moogway82/JamSoftElectronULA/Hardware/BOTTOM Board/BOM_JamSoftElectronULA_BOT.csv

ID | Name | Designator | Footprint | Quantity | Manufacturer Part | Manufacturer | Supplier | Supplier Part | Price
1 | 4K7 | R16,R17,R18,R19 | R0402 | 4 |  |  | JLCPCB | C25900 | 0.001
2 | ElectronULA_2 | U13 | PGA-68_L29.5-W29.5-P2.54-BL_ELECTRON_ULA | 1 |  |  | LCSC | C5156444 | 0.511
3 | 10K | R2 | R0402 | 1 |  |  | JLCPCB | C25744 | 0.001
4 | 22u | DCD-5V | C0603 | 1 |  |  | JLCPCB | C59461 | 0.008
