moogway82/JamSoftElectronULA/Hardware/TOP Board/BOM_JamSoftElectronULA_TOP.csv

ID | Name | Designator | Footprint | Quantity | Manufacturer Part | Manufacturer | Supplier | Supplier Part | Price
1 | 51Ω | RN7,RN8,RN1,RN2,RN3,RN5,RN9,RN10 | RES-ARRAY-SMD_0804-8P-L2.0-W1.0-BL | 8 | CAT10-510J4LF | BOURNS | LCSC | C148527 | 0.035
2 | 50 | R20,R52 | R0402 | 2 |  |  | JLCPCB | C25120 | 0.001
3 | BAT54 | D2 | D_SOD-323_HANDSOLDERING | 1 | NSVBAT54HT1G | onsemi | LCSC | C179609 | 0.102
4 | 1N5819/SOD-123 | U12 | SOD-123_L2.7-W1.7-LS3.8-RD | 1 | 1N4148W | ST(Semtech) | JLCPCB | C81598 | 0.01
5 | ICE40HX1K-VQ100 | U4 | LATC-VQFP-100 | 1 | ICE40HX1K-VQ100 | Lattice | LCSC | C1519043 | 14.318
6 | SN74HCT125D | U10 | TSSOP14 | 1 | 74HCT125PW,118 | Nexperia | LCSC | C131316 | 0.171
7 | 33 | R21 | R0402 | 1 |  |  | JLCPCB | C25105 | 0.001
8 | ULA-ADP-A1 | J2 | HDR-M-2.54_2X10 | 1 |  |  | LCSC | C7494883 | 0.246
9 | ULA-ADP-A2 | J10 | HDR-M-2.54_2X10 | 1 |  |  | LCSC | C7494883 | 0.246
10 | ULA-ADP-A3 | J11 | HDR-M-2.54_2X10 | 1 |  |  | LCSC | C7494883 | 0.246
11 | ULA-ADP-A4 | J12 | HDR-M-2.54_2X10 | 1 |  |  | LCSC | C7494883 | 0.246
12 | TLV1117LV12DCYR | U2 | SOT-223_L6.5-W3.5-P2.30-LS7.0-BR | 1 | TLV1117LV12DCYR | Texas Instruments | LCSC | C80106 | 0.222
13 | 10K | R8,R9,R10,R11,R14,R15,R5,R7,R66,R65,R31,R4,R12,R13,R1,R6 | R0402 | 16 |  |  | JLCPCB | C25744 | 0.001
14 | 22k | R3 | R0402 | 1 |  |  | JLCPCB | C25768 | 0.001
15 | 2.2k | R22 | R0402 | 1 |  |  | JLCPCB | C25879 | 0.001
16 | 470k | R30 | R0402 | 1 |  |  | JLCPCB | C25790 | 0.001
17 | W25X05CLSNIG | U8 | SOIC-8_L4.9-W3.9-P1.27-LS6.0-BL | 1 | W25X05CLSNIG TR | Winbond | LCSC | C401657 | 0.366
18 | PROG | J1 | HDR-M-2.54_2X4 | 1 |  |  | LCSC | C18198018 | 0.137
19 | 10kΩ | RN4,RN6 | RES-ARRAY-SMD_0804-8P-L2.0-W1.0-BL | 2 | CAY10-103J4LF | BOURNS | LCSC | C1731037 | 0.102
20 | LM39100S-3.3 | U1 | SOT-223_L6.5-W3.5-P2.30-LS7.0-BR | 1 | LM39100S-3.3 | HTC Korea TAEJIN Tech | LCSC | C126055 | 0.284
21 | MCP6566R | U5 | SOT-23-5_L3.0-W1.7-P0.95-LS2.8-BR | 1 | MCP6566RT-E/OT | Microchip Tech | LCSC | C623507 | 1.386
22 | 74ALVC164245DGG | U6,U7,U9,U11 | TSSOP-48_L12.6-W6.2-P0.50-LS8.1-BL | 4 | 74ALVC164245DGG:11 | Nexperia | LCSC | C5531 | 0.881
23 | 22u | DCC-5V,DCB-5V,DCB-3V3,DCC-1V2 | C0603 | 4 |  |  | JLCPCB | C59461 | 0.008
24 | 10u | DC6A3,DC6B3,DC7A3,DC7B3,DC9A3,DC9B3,DC11A3,DC11B3,DCA-1V2,DCA-3V3 | C0402 | 10 |  |  | JLCPCB | C15525 | 0.005
25 | 0.1u | DC3,DC6A1,DC6B1,DC7A1,DC7B1,DC9A1,DC9B1,DC11A1,DC5,DC8,DC10,DC4-11,DC4-14,DC4-6,DC4-92,DC4-88,DC4-77,DC4-67,DC4-61,DC4-58,DC4-38,DC4-22,DC4-31,DC4-35,DC11B2,DC11B1,DC6B2,DC6A2,DC11A2,DC9A2,DC7B2,DC7A2,DC9B2 | C0402 | 33 |  |  | JLCPCB | C1525 | 0.001
26 | APX803S00-29SA-7 | U3 | SOT-23-3_L2.9-W1.3-P1.90-LS2.4-BR | 1 | APX803S00-29SA-7 | Diodes Incorporated | LCSC | C526392 | 0.162
