moogway82/JamSoftElectronULA/Schematic_JamSoftElectronULA.pdf

+5V
+3.3V

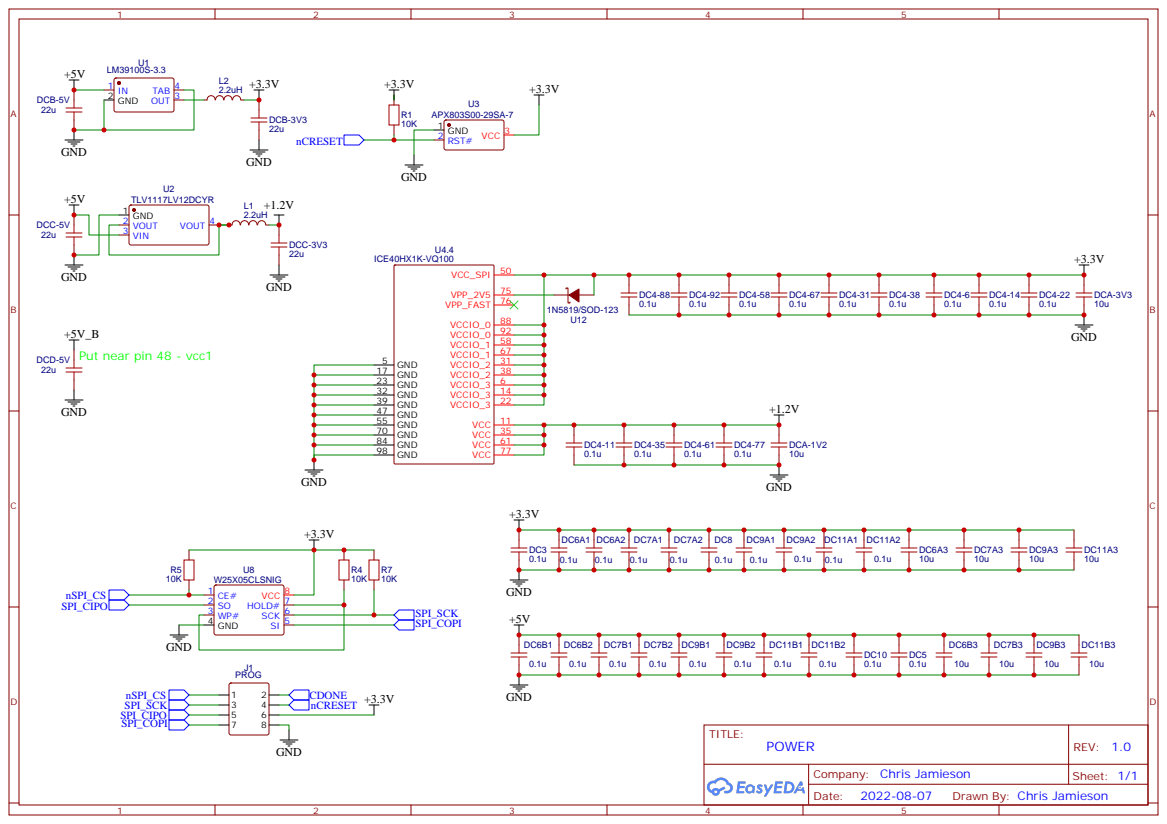
[picture p9: page 1]

Drawn By: Chris Jamieson

# 1B3 6 VCCB

# 2B3 17 VCCB 18

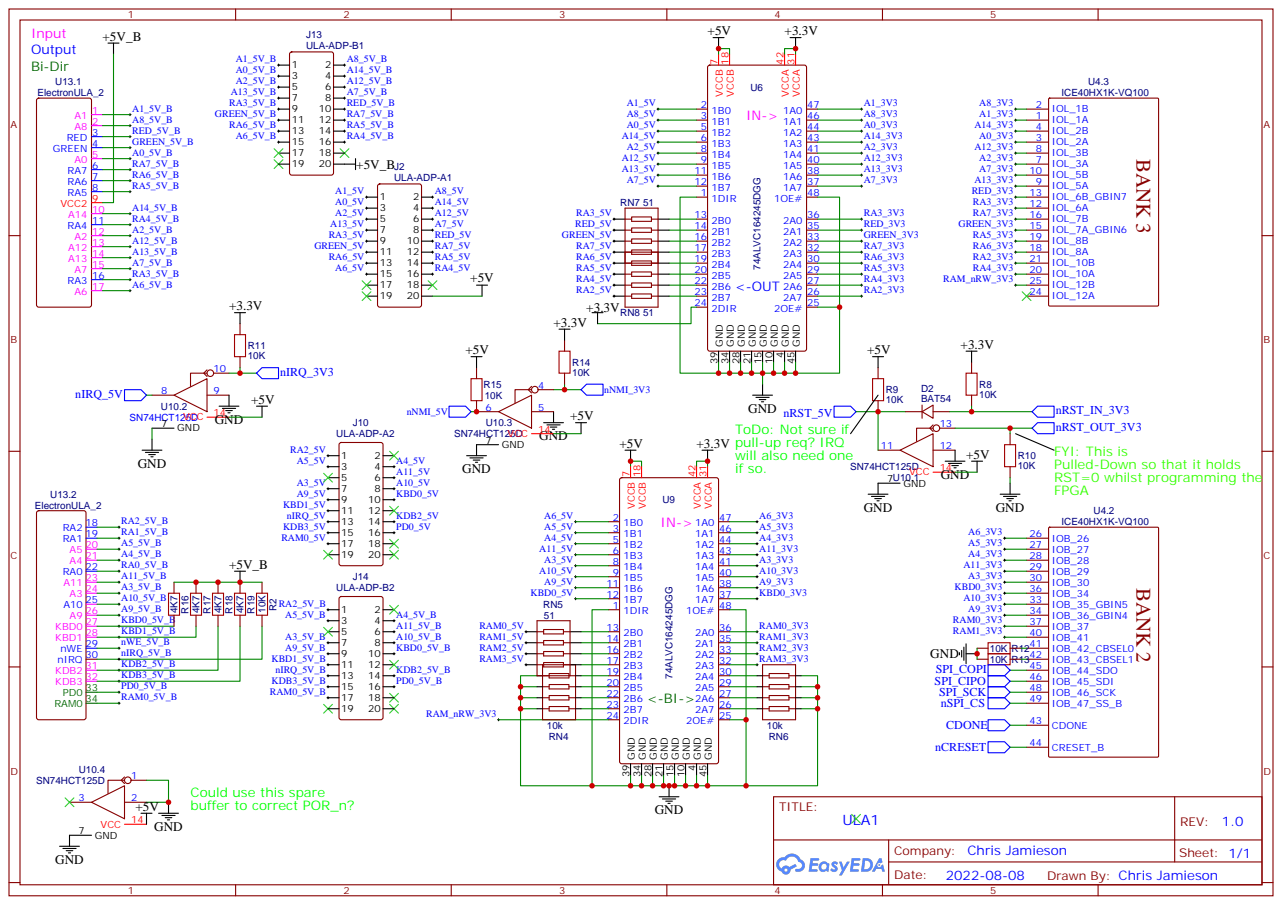
[picture p10: page 2]

ToDo: Not sure if
pull-up req? IRQ
will also need one

Could use this spare
buffer to correct POR_n?

# 1B3 6 VCCB

# 2B3 17 VCCB 18

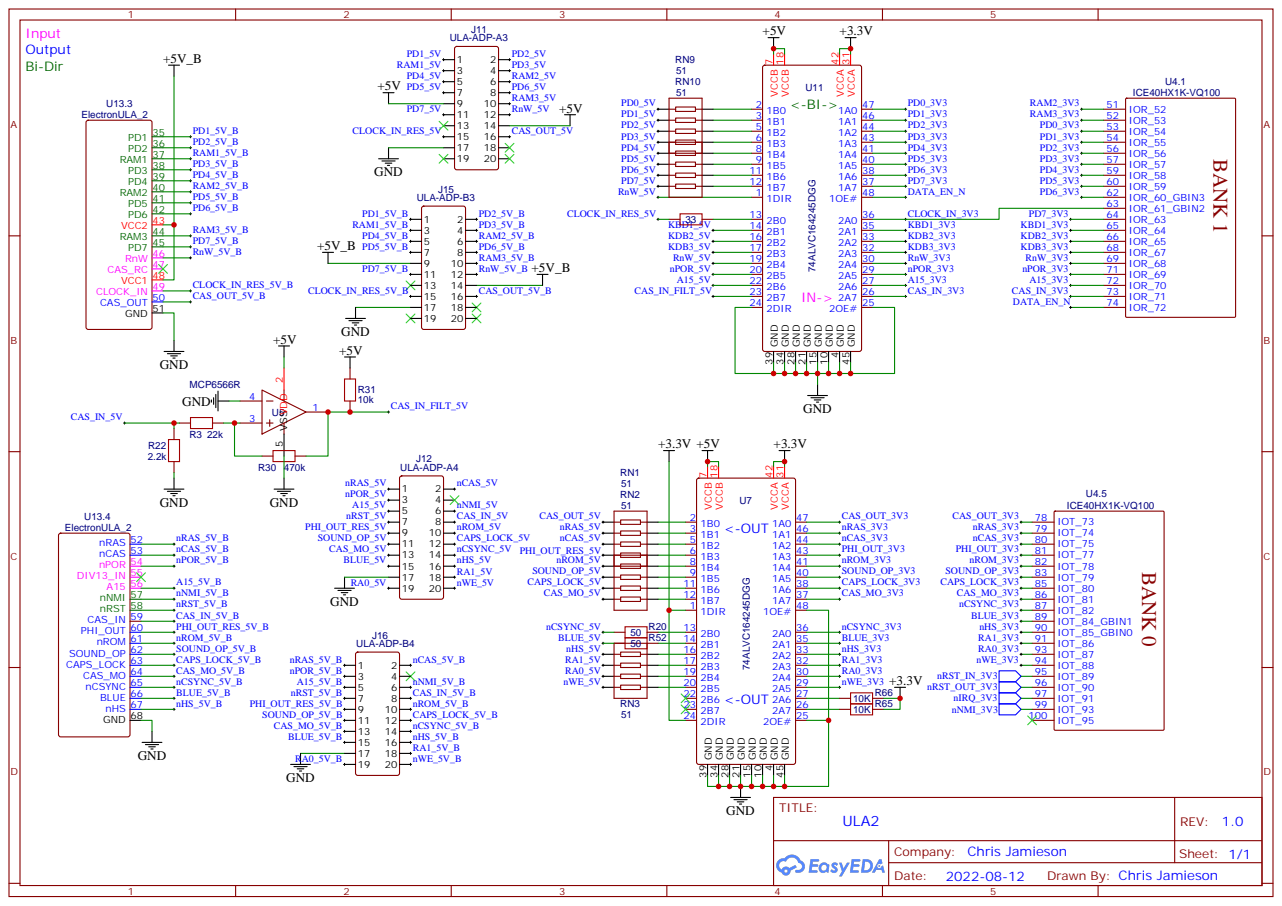
[picture p11: page 3]
