moogway82/JamSoftElectronULA/Hardware/Schematic_JamSoftElectronULA.pdf

+5V
+3.3V

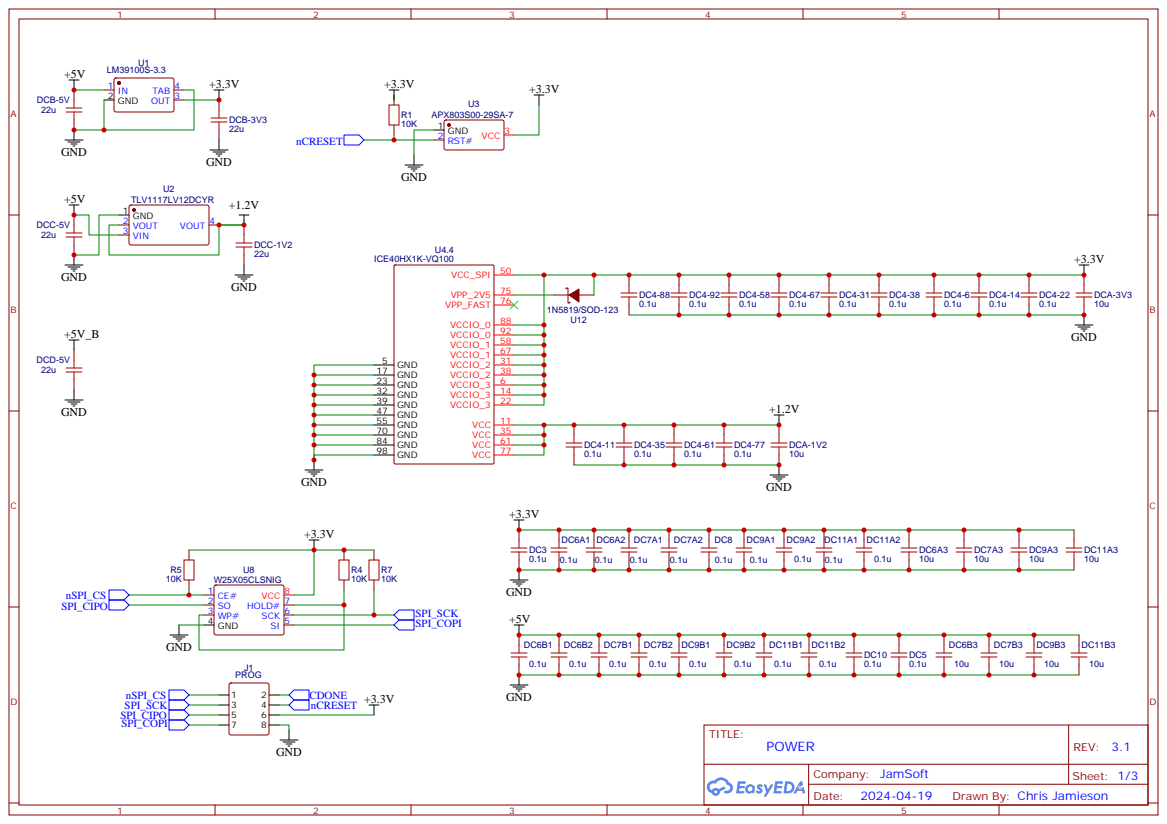
[picture p12: page 1]

Drawn By: Chris Jamieson

# 1B3 6 VCCB

# 2B3 17 VCCB 18

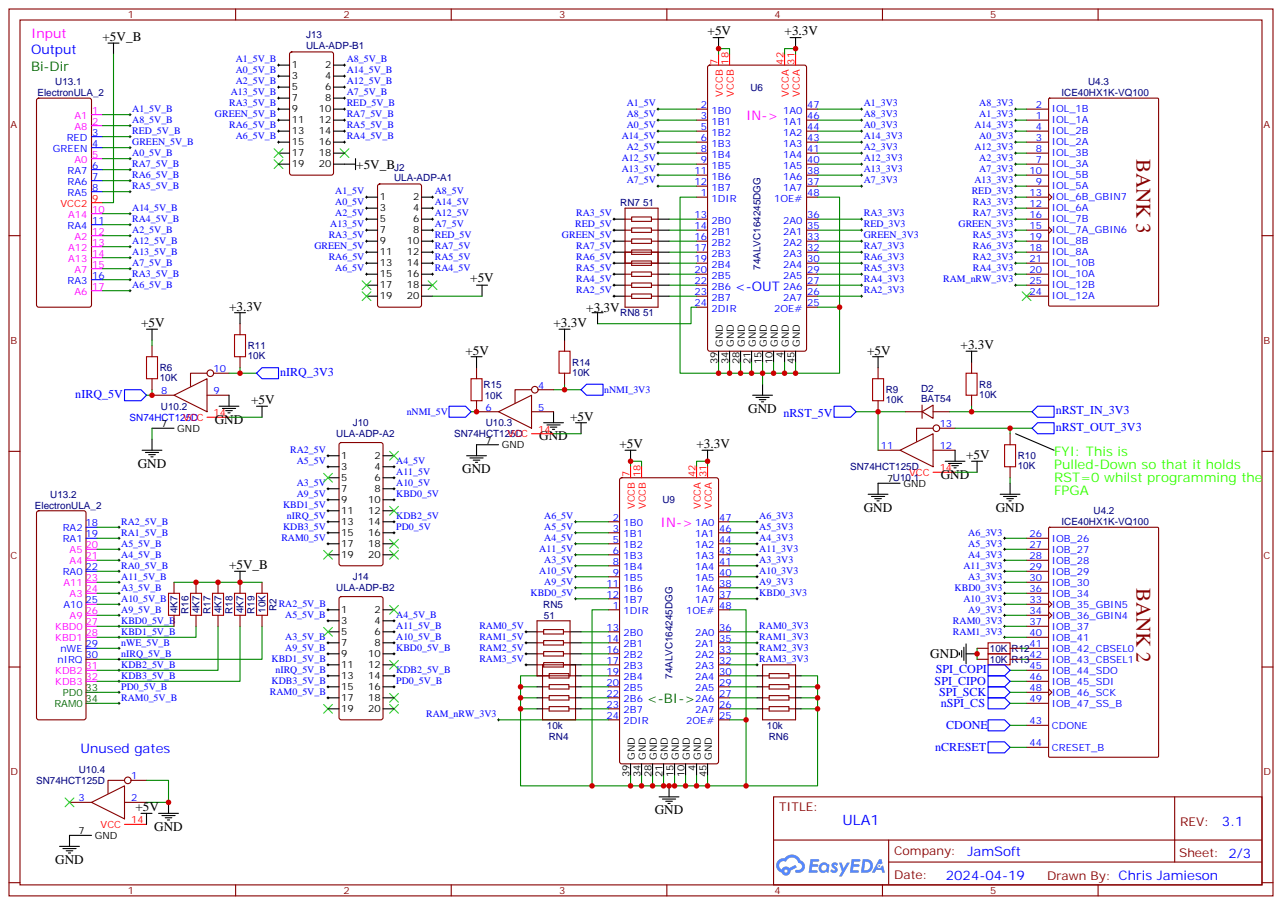
[picture p13: page 2]

# 1B3 6 VCCB

# 2B3 17 VCCB 18

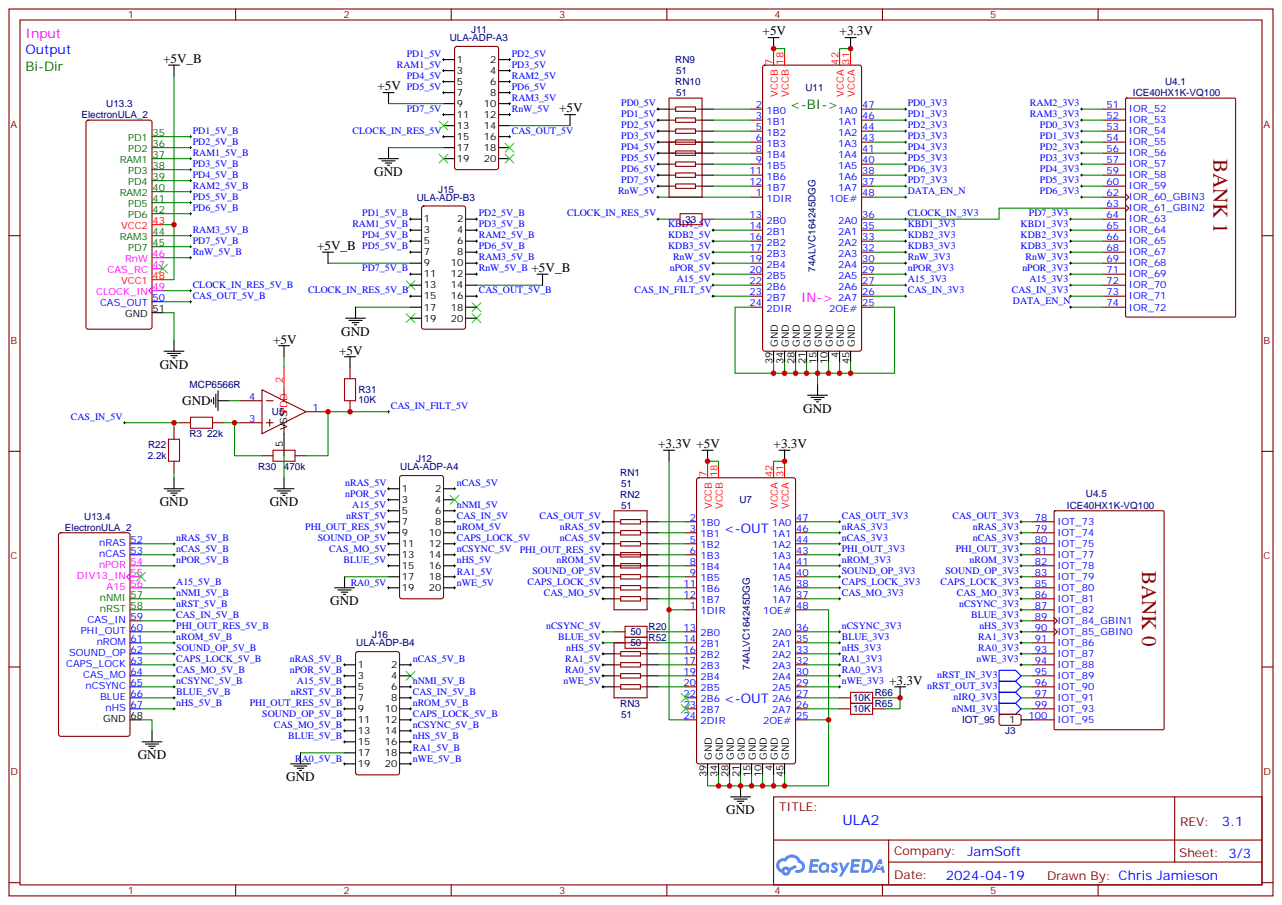
[picture p14: page 3]
