moogway82/JamSoftElectronULA/Hardware/TOP Board/PCB_JamSoftElectronULA_TOP_above.pdf

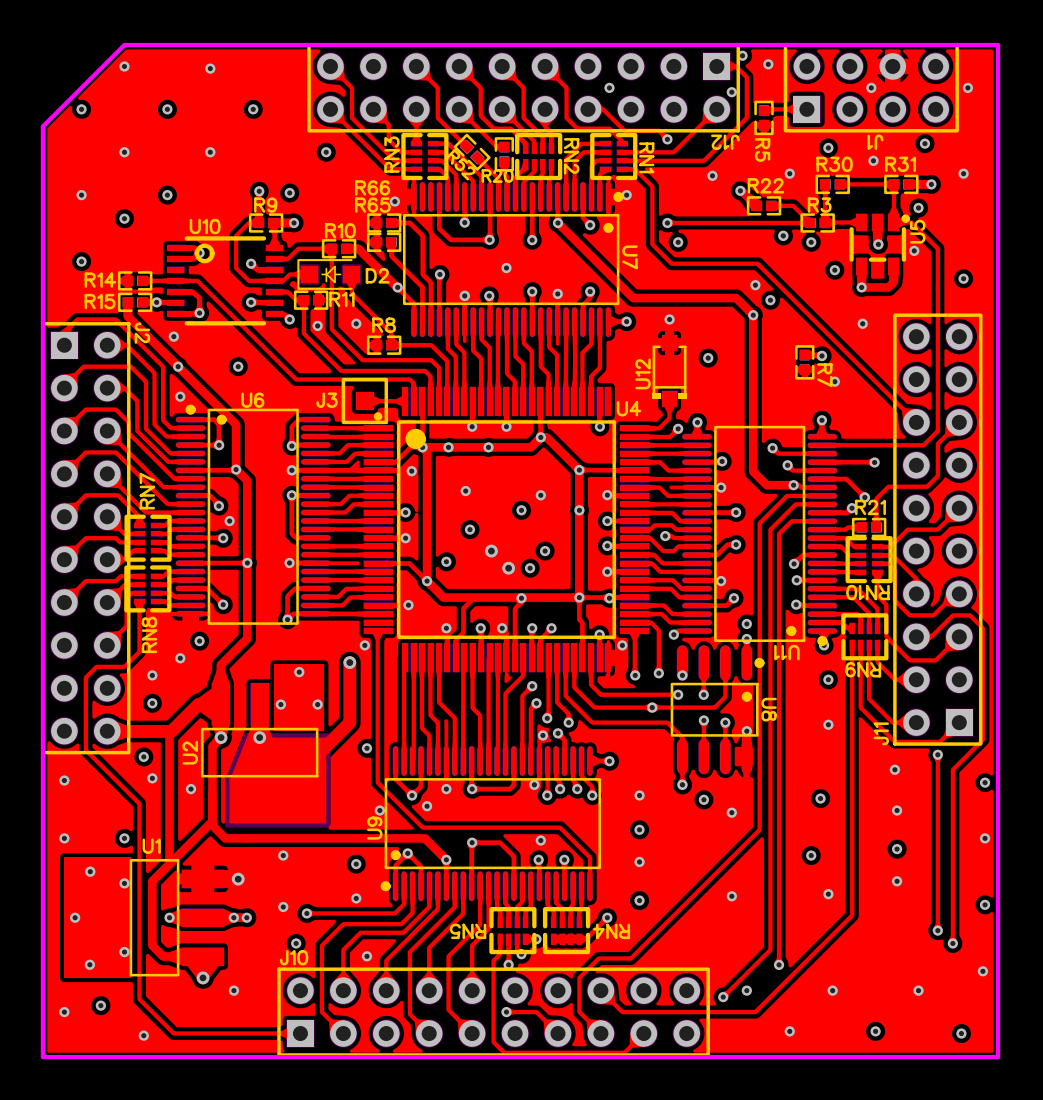
[picture p15: page 1]
