moogway82/JamSoftElectronULA/Hardware/TOP Board/PCB_JamSoftElectronULA_TOP_under.pdf

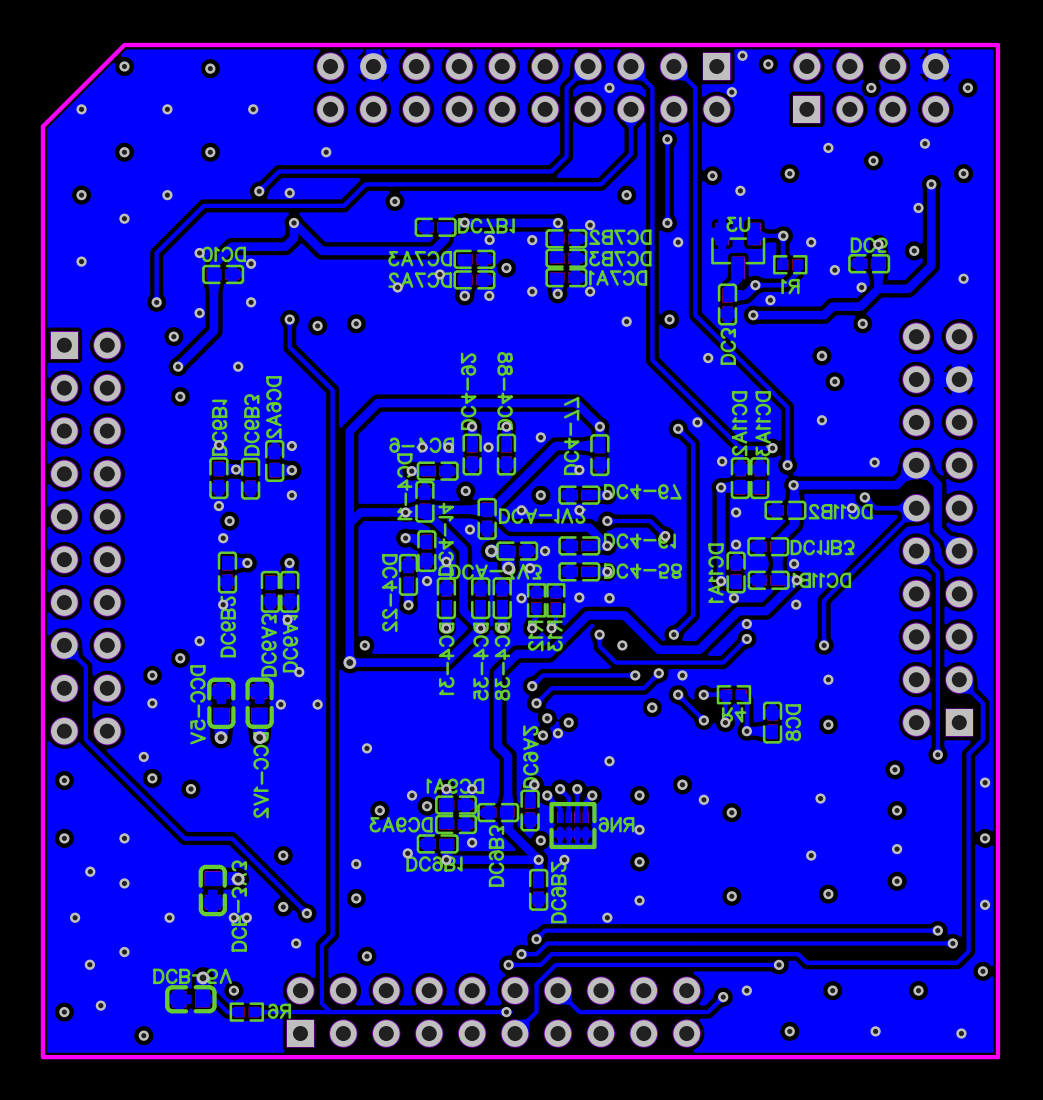
[picture p16: page 1]
