moogway82/JamSoftElectronULA/Hardware/BOTTOM Board/PCB_JamSoftElectronULA_BOT_above.pdf

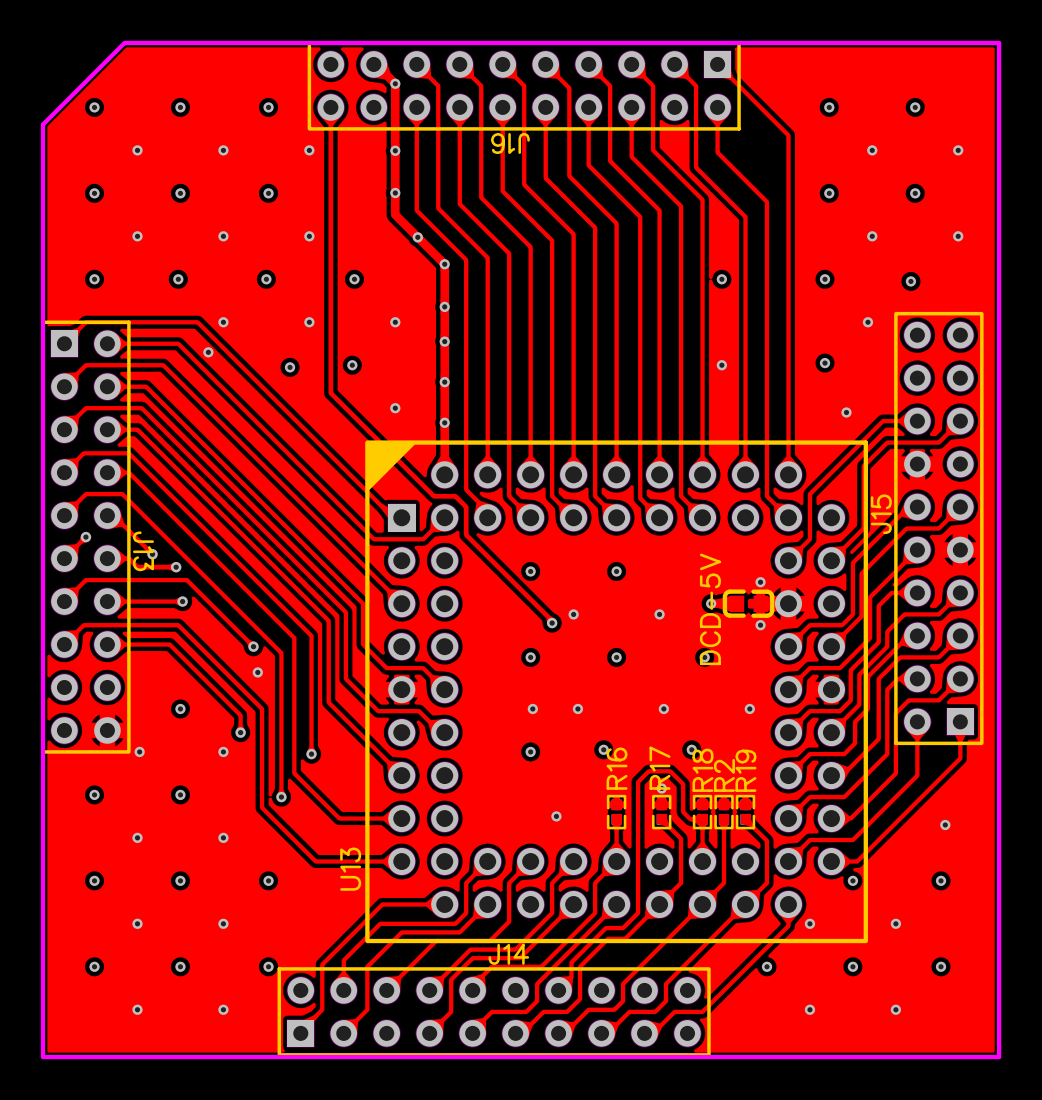
[picture p17: page 1]
