moogway82/JamSoftElectronULA/Hardware/BOTTOM Board/PCB_JamSoftElectronULA_BOT_under.pdf

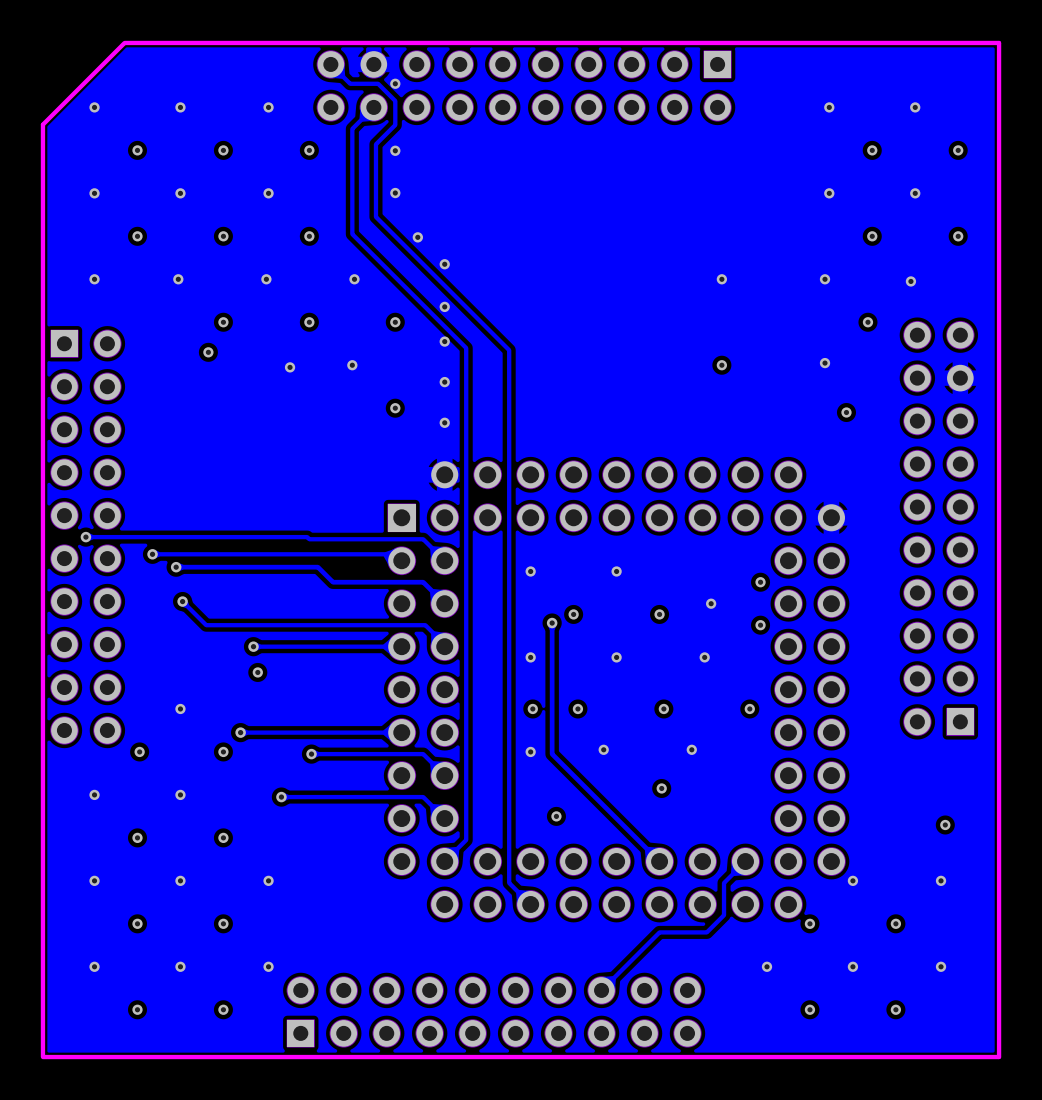
[picture p18: page 1]
