moogway82/JamSoftElectronULA/(list of files, drawings)

Other design files:
Hardware/BOTTOM Board/PCB_JamSoftElectronULA_BOT.json
Hardware/SCH_JamSoftElectronULA.json
Hardware/TOP Board/PCB_JamSoftElectronULA_TOP.json
