moogway82/JamSoftElectronULA/Software/saa5050_rom_dual_port_min.vhd

library ieee;
use ieee.std_logic_1164.all;
use ieee.numeric_std.all;
use std.textio.all;

entity saa5050_rom_dual_port_min is
    generic (
        ADDR_WIDTH       : integer := 11;
        DATA_WIDTH       : integer := 8
    );
    port(
        clock    : in  std_logic;
        addressA : in  std_logic_vector(ADDR_WIDTH-1 downto 0);
        QA       : out std_logic_vector(DATA_WIDTH-1 downto 0)
        --addressB : in  std_logic_vector(ADDR_WIDTH-1 downto 0);
        --QB       : out std_logic_vector(DATA_WIDTH-1 downto 0)
  );
end saa5050_rom_dual_port_min;

architecture RTL of saa5050_rom_dual_port_min is

    constant MEM_DEPTH : integer := 2**ADDR_WIDTH;

    type mem_type is array (0 to MEM_DEPTH-1) of signed(DATA_WIDTH-1 downto 0);

    shared variable mem : mem_type := (
    x"00",x"00",x"00",x"00",x"00",x"00",x"00",x"00",
	x"00",x"00",x"00",x"00",x"00",x"00",x"00",x"00",
	x"00",x"00",x"00",x"00",x"00",x"00",x"00",x"00",
	x"00",x"00",x"00",x"00",x"00",x"00",x"00",x"00",
	x"00",x"00",x"00",x"00",x"00",x"00",x"00",x"00",
	x"00",x"00",x"00",x"00",x"00",x"00",x"00",x"00",
	x"00",x"00",x"00",x"00",x"00",x"00",x"00",x"00",
	x"00",x"00",x"00",x"00",x"00",x"00",x"00",x"00",
	x"00",x"00",x"00",x"00",x"00",x"00",x"00",x"00",
	x"00",x"00",x"00",x"00",x"00",x"00",x"00",x"00",
	x"00",x"00",x"00",x"00",x"00",x"00",x"00",x"00",
	x"00",x"00",x"00",x"00",x"00",x"00",x"00",x"00",
	x"00",x"00",x"00",x"00",x"00",x"00",x"00",x"00",
	x"00",x"00",x"00",x"00",x"00",x"00",x"00",x"00",
	x"00",x"00",x"00",x"00",x"00",x"00",x"00",x"00",
	x"00",x"00",x"00",x"00",x"00",x"00",x"00",x"00",
	x"00",x"00",x"00",x"00",x"00",x"00",x"00",x"00",
	x"00",x"00",x"00",x"00",x"00",x"00",x"00",x"00",
	x"00",x"00",x"00",x"00",x"00",x"00",x"00",x"00",
	x"00",x"00",x"00",x"00",x"00",x"00",x"00",x"00",
	x"00",x"00",x"00",x"00",x"00",x"00",x"00",x"00",
	x"00",x"00",x"00",x"00",x"00",x"00",x"00",x"00",
	x"00",x"00",x"00",x"00",x"00",x"00",x"00",x"00",
	x"00",x"00",x"00",x"00",x"00",x"00",x"00",x"00",
	x"00",x"00",x"00",x"00",x"00",x"00",x"00",x"00",
	x"00",x"00",x"00",x"00",x"00",x"00",x"00",x"00",
	x"00",x"00",x"00",x"00",x"00",x"00",x"00",x"00",
	x"00",x"00",x"00",x"00",x"00",x"00",x"00",x"00",
	x"00",x"00",x"00",x"00",x"00",x"00",x"00",x"00",
	x"00",x"00",x"00",x"00",x"00",x"00",x"00",x"00",
	x"00",x"00",x"00",x"00",x"00",x"00",x"00",x"00",
	x"00",x"00",x"00",x"00",x"00",x"00",x"00",x"00",
	x"00",x"00",x"00",x"00",x"00",x"00",x"00",x"00",
	x"00",x"00",x"00",x"00",x"00",x"00",x"00",x"00",
	x"00",x"00",x"00",x"00",x"00",x"00",x"00",x"00",
	x"00",x"00",x"00",x"00",x"00",x"00",x"00",x"00",
	x"00",x"00",x"00",x"00",x"00",x"00",x"00",x"00",
	x"00",x"00",x"00",x"00",x"00",x"00",x"00",x"00",
	x"00",x"00",x"00",x"00",x"00",x"00",x"00",x"00",
	x"00",x"00",x"00",x"00",x"00",x"00",x"00",x"00",
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

 begin
 
    process(clock) is
    begin
        if (rising_edge(clock)) then
            QA <= std_logic_vector(mem(to_integer(unsigned(addressA))));
        end if;
    end process;

    --process(clock) is
    --begin
    --    if (rising_edge(clock)) then    
    --        QB <= std_logic_vector(mem(to_integer(unsigned(addressB))));
    --    end if;
    --end process;
end RTL;
