moogway82/JamSoftElectronULA/(commit log)

2023-05-09 Adding the current Schematic
2023-06-08 Fixes: Stopped VRAM being written to at same time as ULA regs. Improved DRAM reliability. Load first byte of the screen at the right time.
    [JamSoftElectronULA.vhd, JamSoftElectronULA_TB2.vhd, JamSoftElectronULA_vidtest2_TB.vhd, JamSoftElectronULA_vidtest_TB.vhd]
2024-01-28 Made a lot of changes to support TMS6146 RAM which was causing snow and crashes as the chips warmed up. - Removed delayed contention1 & contention2 signals from Utimate Elk ULA code as they didn't se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
    [JamSoftElectronULA.vhd, JamSoftElectronULA_TB2.vhd, tm4164ea4_64k_w4.vhd]
2024-03-05 Updated the schematic to the v2 design - added tape input signal conditioning, fix the data bidir buffer enable, adding dampnening resistors, extra decoupling caps to power. Not sure inductors on the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
2024-05-03 First draft of the public release.
    [BOM_JamSoftElectronULA_BOT.csv, BOM_JamSoftElectronULA_TOP.csv, PCB_JamSoftElectronULA_BOT.json, PCB_JamSoftElectronULA_TOP.json, PickAndPlace_PCB_JamSoftElectronULA_BOT.csv, PickAndPlace_PCB_JamSoftElectronULA_TOP.csv, SCH_JamSoftElectronULA.json]
2024-05-04 Added Raspberry Pi programming option. Fixed listed in README.
2024-05-05 Fixed some links, tweaked wording and renamed HDL -> Software for clarity
    [JamSoftElectronULA.pcf, JamSoftElectronULA.vhd, JamSoftElectronULA_TB.vhd, JamSoftElectronULA_TB2.vhd, JamSoftElectronULA_vidtest2_TB.vhd, JamSoftElectronULA_vidtest_TB.vhd, tm4164ea4_64k_w4.vhd, turbo_ram.vhd]
2024-05-07 Added some more checks before joining the boards. Added missing labels to two resistors.
    [PCB_JamSoftElectronULA_TOP.json]
2024-05-15 Added diode symbol. Added first test for FPGA to check signals.
    [PCB_JamSoftElectronULA_TOP.json]
2024-07-09 Synth PoR, nHS non-inverted, Caps inverted & config slow (#2)
    * Sythesising PoR as real one has hysterysis issues and could come before FGPA was configured. nHS has correct polarity. Caps now has correct polarity too. Changes to TB, not tidied up, WIP. Set Configuration Speed back to normal (slow) as more reliable and gives longer for system to stabilise on power up.Removed some references to PoR and acknowldeged Ronin47s help.
    * Forgot to add new bin file and update README to reflect it.
    * Forgot to add 64k bin file for programming using flashrom
    [JamSoftElectronULA.pcf, JamSoftElectronULA.vhd, JamSoftElectronULA_TB2.vhd]
2026-04-15 Added in SAA5050, generated a 6MHz clock enable for it. Switched for Turbo to make space in BRAM.
2026-04-16 ttxt_lose was bad so fixed it a bit. char_row and line_counter look much more aligned now, really interested to try this out now
    [JamSoftElectronULA.vhd]
2026-04-21 Found the issue with screen scrolling - I hadn't enabled the data buffer for the FC1x range, so the addr reg wasnt getting set and the start reg either. It was a bit of a fluke it worked at all, just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
    [JamSoftElectronULA.vhd]
2026-04-23 Seperated the Jafa CRTC Start Address register from the Elk ULA Start address register and added a mux to switch between them. Hopefully that'll mean writes to the Elk ULA one will not affect Mode 7 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
2026-04-23 Forgot to reset cursor signals. Added experimental cursor blinking code
    [JamSoftElectronULA.vhd]
2026-04-24 Much improved cursor, still a couple of niggles, but much better, can set thickness, and shows on correct row, but still overlaps at end and needs pushing forward a pixel or two
    [JamSoftElectronULA.vhd, JamSoftElectronULA_TB2.vhd]
2026-04-26 Fixed the cursor wrapping issue. Cursor isnt quite in the righ tplace still, but it's better. Had it forward just a bit too much so need to work on it.
    [JamSoftElectronULA.vhd]
2026-04-27 Stripping out the dual ported bits to see if that saves LUTs (it didn't).
    [JamSoftElectronULA.vhd, JamSoftElectronULA_TB2.vhd]
2026-04-28 Excellent, turbo is back and working with Mode 7. Only issue now is that the Mode 7 gfx characters are missing so need to add them in from the generator
    [JamSoftElectronULA.vhd, saa5050_rom_dual_port_min.vhd, turbo_ram.vhd]
2026-04-28 Whoop it mostly works turbo and Mode 7 gfx, but looks like a bug in the gfx char generator, so need to look at that circuit again.
    [JamSoftElectronULA.vhd]
2026-04-28 Fixed the gfx char generator, it was using NORs not NANDs... Tidied up old comment lines and switching to the new smaller Mode7 Char ROM.
    [JamSoftElectronULA.vhd]
2026-05-05 Build using Jan OSS CAD SUITE oss-cad-suite-linux-x64-20260123
2026-05-05 Build using even newer version of OSS CAD Suide oss-cad-suite-linux-x64-20260505. Did most of the Mode 7 dev using the old oss-cad-suite-linux-x64-20250714 version but this newer version uses less LU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
